xisphias/Lysimeter/logger/data/20170712/output/0711points1hr.png

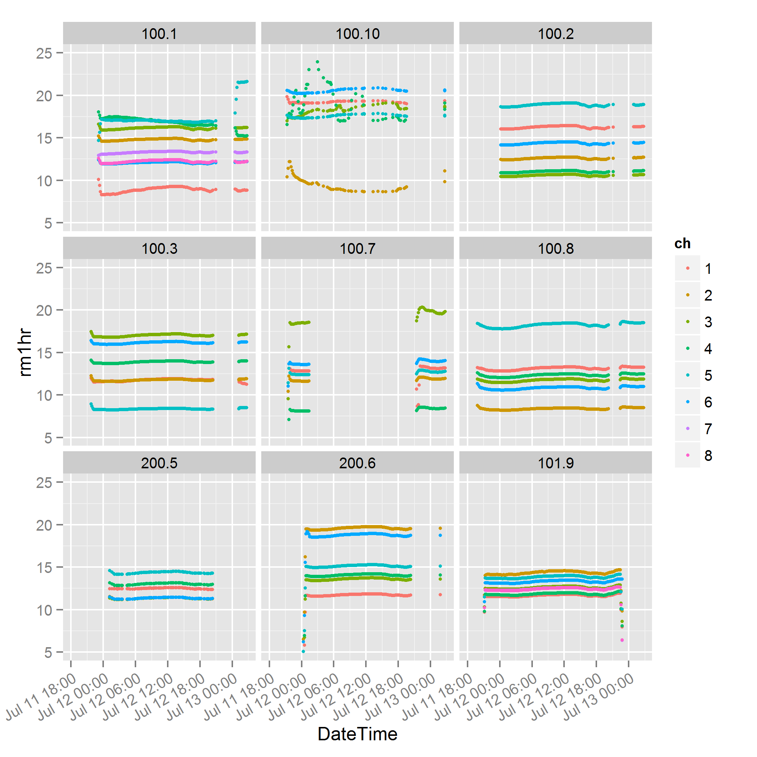
logger/data/20170712/output/0711points1hr.png
