xisphias/Lysimeter/logger/data/20170712/output/0712ETmm.png

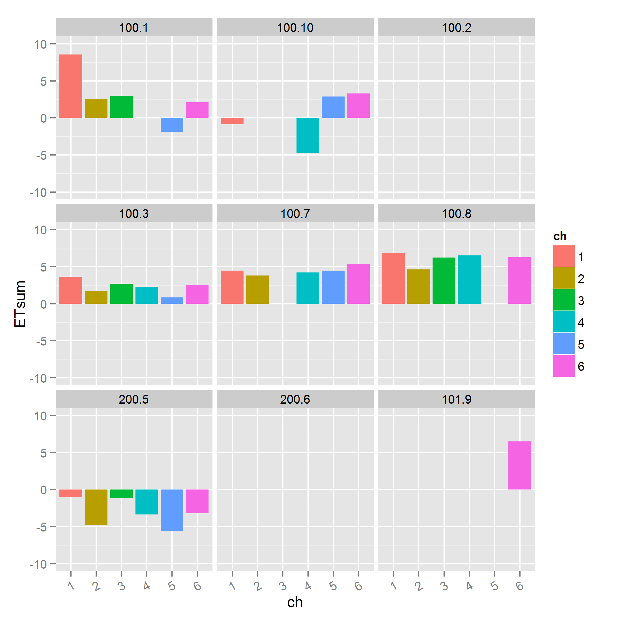
logger/data/20170712/output/0712ETmm.png
