xisphias/Lysimeter/logger/data/20170712/output/allpoints.png

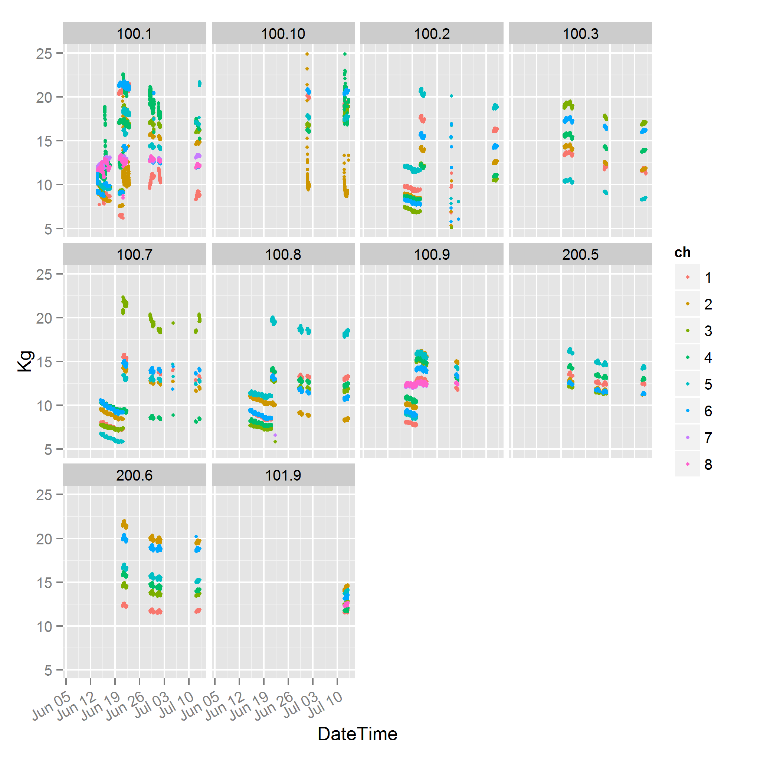
logger/data/20170712/output/allpoints.png
