xisphias/Lysimeter/node/pcb/brd_bottom.png

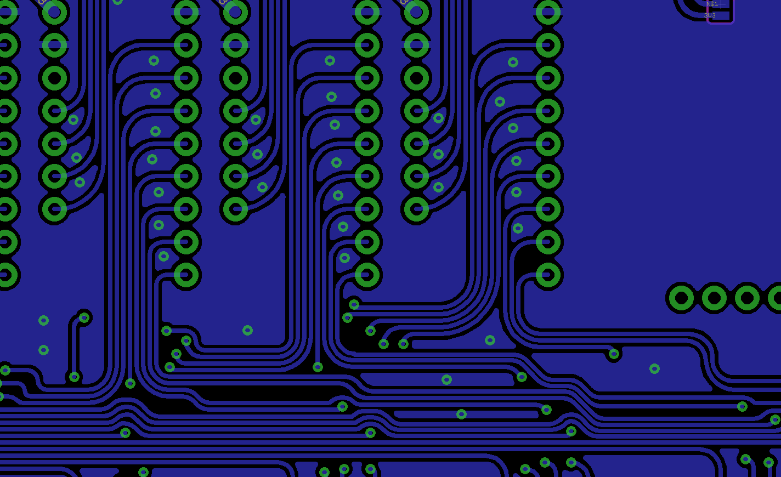
node/pcb/brd_bottom.png
