xisphias/Lysimeter/node/pcb/brd_silk.png

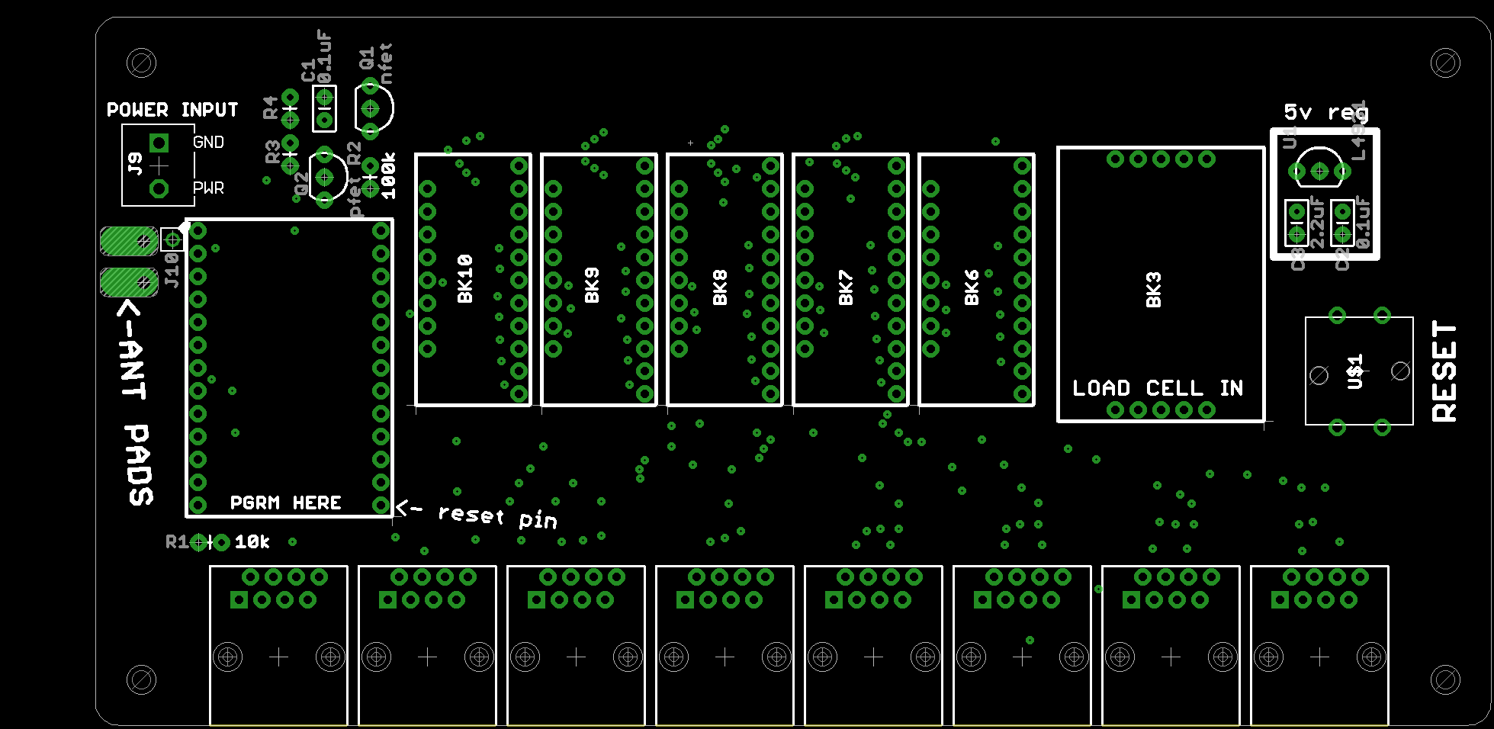
node/pcb/brd_silk.png
