xisphias/Lysimeter/node/pcb/brd_top.png

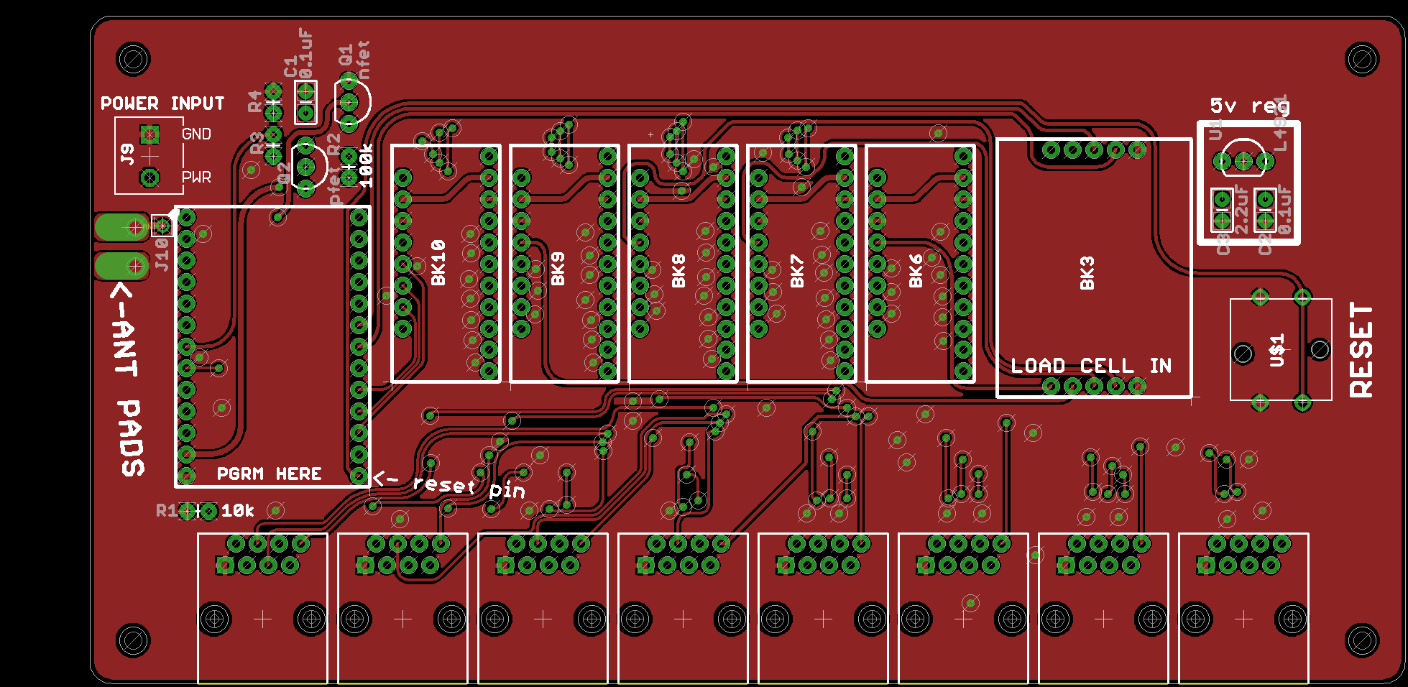
node/pcb/brd_top.png
