xisphias/Lysimeter/node/pcb/schematic.png

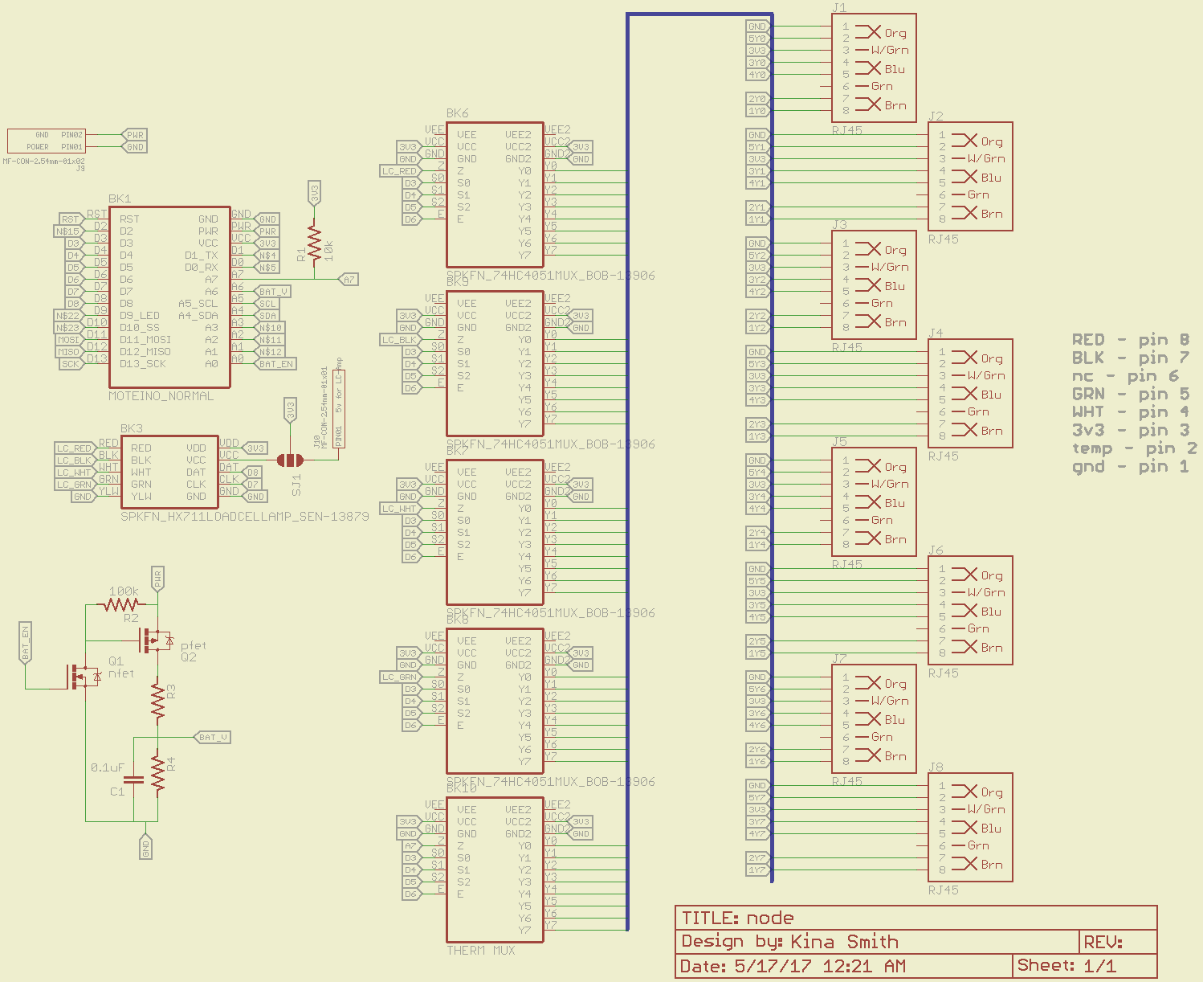
node/pcb/schematic.png
