xisphias/Lysimeter/node/pcb/schematicv2.png

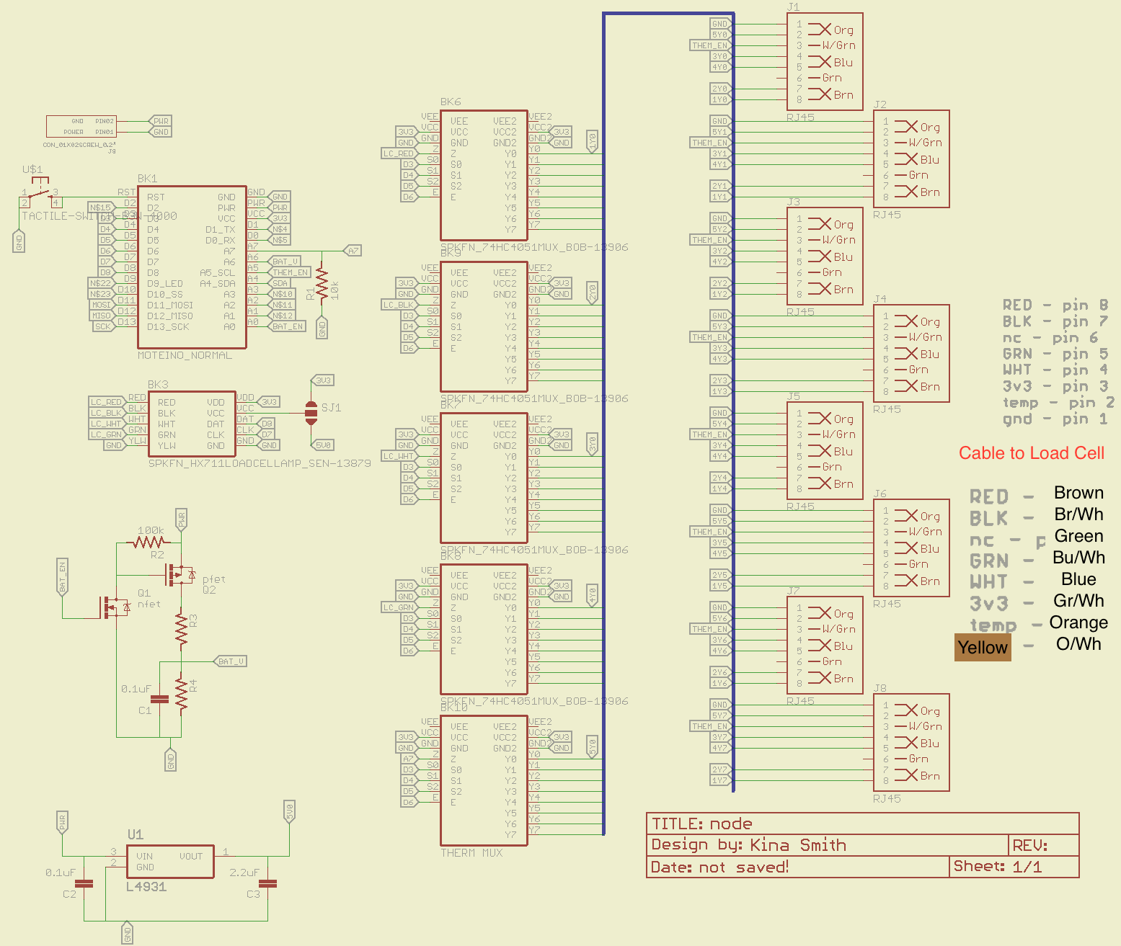
node/pcb/schematicv2.png
