xisphias/Lysimeter/logger/data/test_20170601_100_9.csv

batV | bTemp | nodeID | unixtime | ch1KG | ch1Temp | ch2KG | ch2Temp
0.01 | 21 | 100.9 | 1496267373 | 0.02 | 18.95 | 0.04 | 18.42
0.3 | 21 | 100.9 | 1496267392 | 0.02 | 19.04 | 0.04 | 18.51
0.04 | 22 | 100.9 | 1496267411 | 0.02 | 19.21 | 0.04 | 18.6
0.04 | 22 | 100.9 | 1496267469 | 0.02 | 19.21 | 0.04 | 18.6
0.04 | 22 | 100.9 | 1496267489 | 0.02 | 19.3 | 0.04 | 18.6
0.04 | 22 | 100.9 | 1496267508 | 0.02 | 19.3 | 0.04 | 18.6
0.06 | 22 | 100.9 | 1496267527 | 0.02 | 19.39 | 0.04 | 18.68
0.04 | 22 | 100.9 | 1496267546 | 0.02 | 19.39 | 0.04 | 18.68
0.04 | 22 | 100.9 | 1496267565 | 3.56 | 19.39 | 3.41 | 18.68
0.04 | 22 | 100.9 | 1496267584 | 3.56 | 19.39 | 3.41 | 18.68
0.04 | 22 | 100.9 | 1496267604 | 3.56 | 19.39 | 3.41 | 18.68
0.03 | 22 | 100.9 | 1496267642 | 3.56 | 19.48 | 3.41 | 18.68
0.04 | 22 | 100.9 | 1496267662 | 3.56 | 19.48 | 3.41 | 18.68
0.04 | 22 | 100.9 | 1496267681 | 3.56 | 19.48 | 3.41 | 18.68
0.04 | 22 | 100.9 | 1496267700 | 3.56 | 19.48 | 3.41 | 18.68
0.04 | 22 | 100.9 | 1496267719 | 3.56 | 19.48 | 3.41 | 18.77
0.03 | 23 | 100.9 | 1496267758 | 3.56 | 19.48 | 3.41 | 18.77
0.04 | 22 | 100.9 | 1496267777 | 3.56 | 19.56 | 3.41 | 18.77
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
