xisphias/Lysimeter/node/pcb/node.brd

## EAGLE design node/pcb/node.brd (2017-05-31, last stored version)

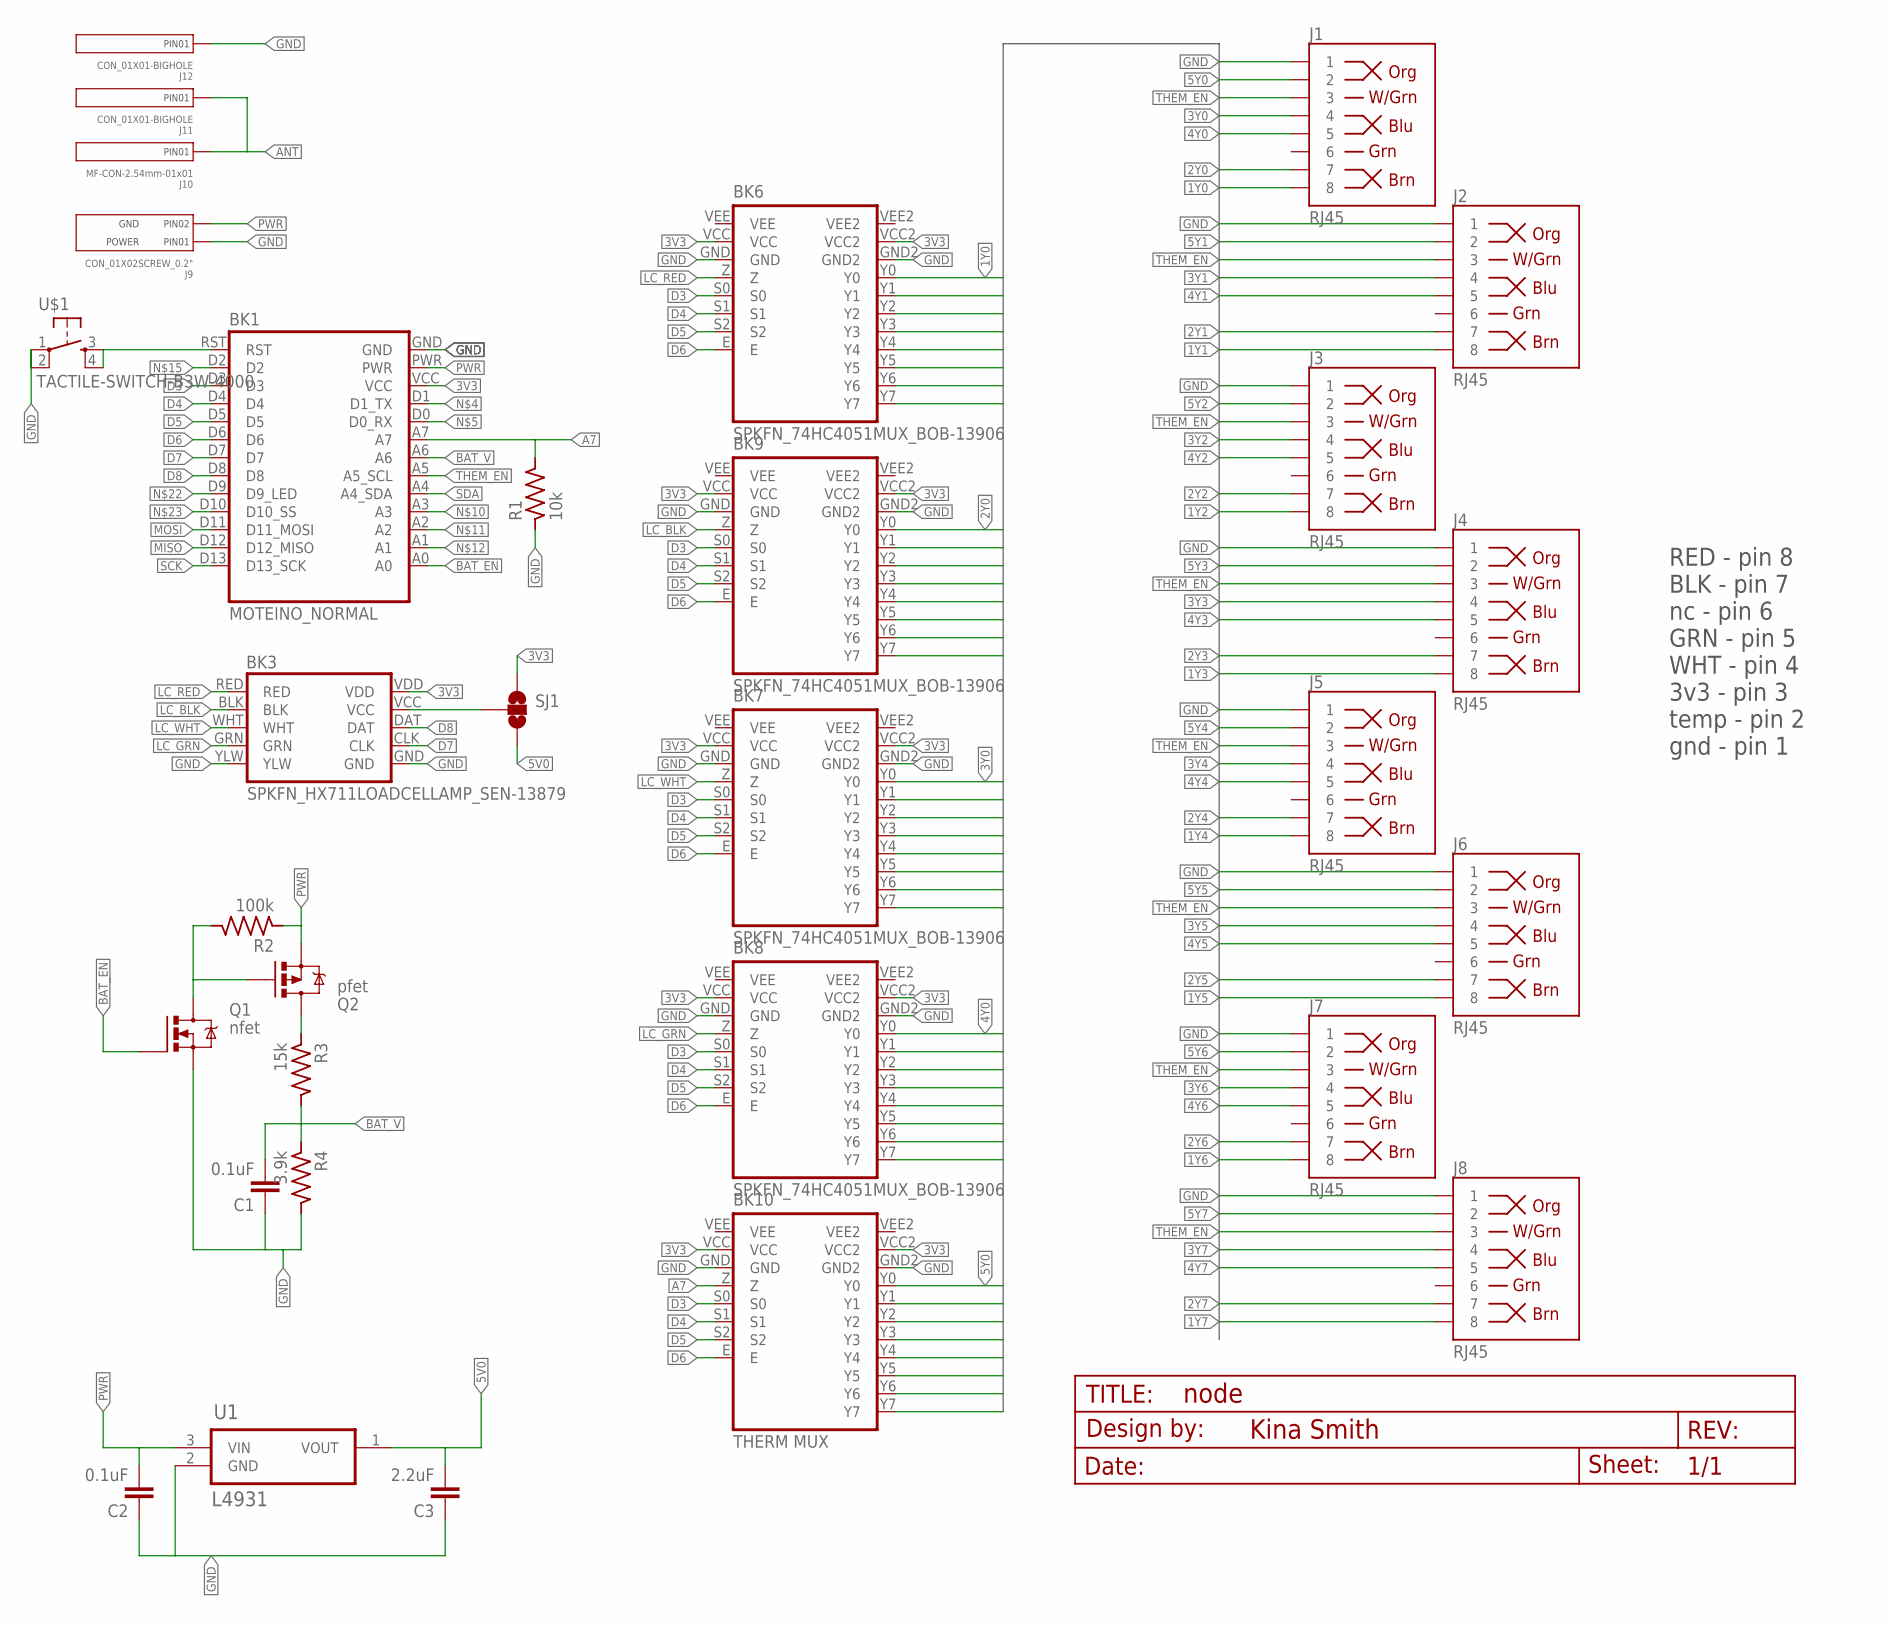
[picture p9: schematic node.sch]

Parts:
BK1: MOTEINO_NORMAL
BK3: SPKFN_HX711LOADCELLAMP_SEN-13879
BK6, BK7, BK8, BK9: SPKFN_74HC4051MUX_BOB-13906
BK10: THERM MUX; SPKFN_74HC4051MUX_BOB-13906
C1, C2: 0.1uF; CAP-PTH-SMALL2
C3: 2.2uF; CAP-PTH-SMALL2
FRAME1: FRAME-LETTERNO_PACKAGE; DUMMY
J1, J2, J3, J4, J5, J6, J7, J8: RJ45; RJ45-8
J9: CON_01X02SCREW_0.2"; SCREW_TERM_2POS
J10: MF-CON-2.54mm-01x01; PTH_2.54MM_01X01
J11, J12: CON_01X01-BIGHOLE; 1X01_BIGHOLE
Q1: nfet; TO-92-AMMO
Q2: pfet; TO-92-AMMO
R1: 10k; AXIAL-0.1
R2: 100k; AXIAL-0.1
R3: 15k; AXIAL-0.1
R4: 3.9k; AXIAL-0.1
SJ1: SOLDERJUMPER_2WAYS; SJ_3
U1: L4931; TO-92-AMMO
U$1: TACTILE-SWITCH-B3W-4000; B3W-4000

Connections:
1Y0: BK6.Y0, J1.8
1Y1: BK6.Y1, J2.8
1Y2: BK6.Y2, J3.8
1Y3: BK6.Y3, J4.8
1Y4: BK6.Y4, J5.8
1Y5: BK6.Y5, J6.8
1Y6: BK6.Y6, J7.8
1Y7: BK6.Y7, J8.8
2Y0: BK9.Y0, J1.7
2Y1: BK9.Y1, J2.7
2Y2: BK9.Y2, J3.7
2Y3: BK9.Y3, J4.7
2Y4: BK9.Y4, J5.7
2Y5: BK9.Y5, J6.7
2Y6: BK9.Y6, J7.7
2Y7: BK9.Y7, J8.7
3V3: BK1.VCC, BK3.VDD, BK6.VCC, BK6.VCC2, BK7.VCC, BK7.VCC2, BK8.VCC, BK8.VCC2, BK9.VCC, BK9.VCC2, BK10.VCC, BK10.VCC2, SJ1.1
3Y0: BK7.Y0, J1.4
3Y1: BK7.Y1, J2.4
3Y2: BK7.Y2, J3.4
3Y3: BK7.Y3, J4.4
3Y4: BK7.Y4, J5.4
3Y5: BK7.Y5, J6.4
3Y6: BK7.Y6, J7.4
3Y7: BK7.Y7, J8.4
4Y0: BK8.Y0, J1.5
4Y1: BK8.Y1, J2.5
4Y2: BK8.Y2, J3.5
4Y3: BK8.Y3, J4.5
4Y4: BK8.Y4, J5.5
4Y5: BK8.Y5, J6.5
4Y6: BK8.Y6, J7.5
4Y7: BK8.Y7, J8.5
5V0: C3.2, SJ1.3, U1.1 (VOUT)
5Y0: BK10.Y0, J1.2
5Y1: BK10.Y1, J2.2
5Y2: BK10.Y2, J3.2
5Y3: BK10.Y3, J4.2
5Y4: BK10.Y4, J5.2
5Y5: BK10.Y5, J6.2
5Y6: BK10.Y6, J7.2
5Y7: BK10.Y7, J8.2
A7: BK1.A7, BK10.Z, R1.P$2
ANT: J10.P$1, J11.P$1, J11.P$2
BAT_EN: BK1.A0, Q1.2 (G)
BAT_V: BK1.A6, C1.2, R3.P$2, R4.P$1
D3: BK1.D3, BK6.S0, BK7.S0, BK8.S0, BK9.S0, BK10.S0
D4: BK1.D4, BK6.S1, BK7.S1, BK8.S1, BK9.S1, BK10.S1
D5: BK1.D5, BK6.S2, BK7.S2, BK8.S2, BK9.S2, BK10.S2
D6: BK1.D6, BK6.E, BK7.E, BK8.E, BK9.E, BK10.E
D7: BK1.D7, BK3.CLK
D8: BK1.D8, BK3.DAT
GND: BK1.GND, BK3.GND, BK3.YLW, BK6.GND, BK6.GND2, BK7.GND, BK7.GND2, BK8.GND, BK8.GND2, BK9.GND, BK9.GND2, BK10.GND, BK10.GND2, C1.1, C2.1, C3.1, J1.1, J2.1, J3.1, J4.1, J5.1, J6.1, J7.1, J8.1, J9.GND (PIN1), J12.P$1, J12.P$2, Q1.1 (S), R1.P$1, R4.P$2, U1.2 (GND), U$1.1, U$1.2
LC_BLK: BK3.BLK, BK9.Z
LC_GRN: BK3.GRN, BK8.Z
LC_RED: BK3.RED, BK6.Z
LC_WHT: BK3.WHT, BK7.Z
MISO: BK1.D12 (D12_MISO)
MOSI: BK1.D11 (D11_MOSI)
unnamed: BK3.VCC, SJ1.2
unnamed: Q1.3 (D), Q2.2 (G), R2.P$2
unnamed: Q2.1 (D), R3.P$1
PWR: BK1.PWR, C2.2, J9.PWR (PIN2), Q2.3 (S), R2.P$1, U1.3 (VIN)
RST: BK1.RST, U$1.3, U$1.4
SCK: BK1.D13 (D13_SCK)
SDA: BK1.A4 (A4_SDA)
THEM_EN: BK1.A5 (A5_SCL), J1.3, J2.3, J3.3, J4.3, J5.3, J6.3, J7.3, J8.3

Notes on the sheet:
RED - pin 8 BLK - pin 7 nc - pin 6 GRN - pin 5 WHT - pin 4 3v3 - pin 3 temp - pin 2 gnd - pin 1

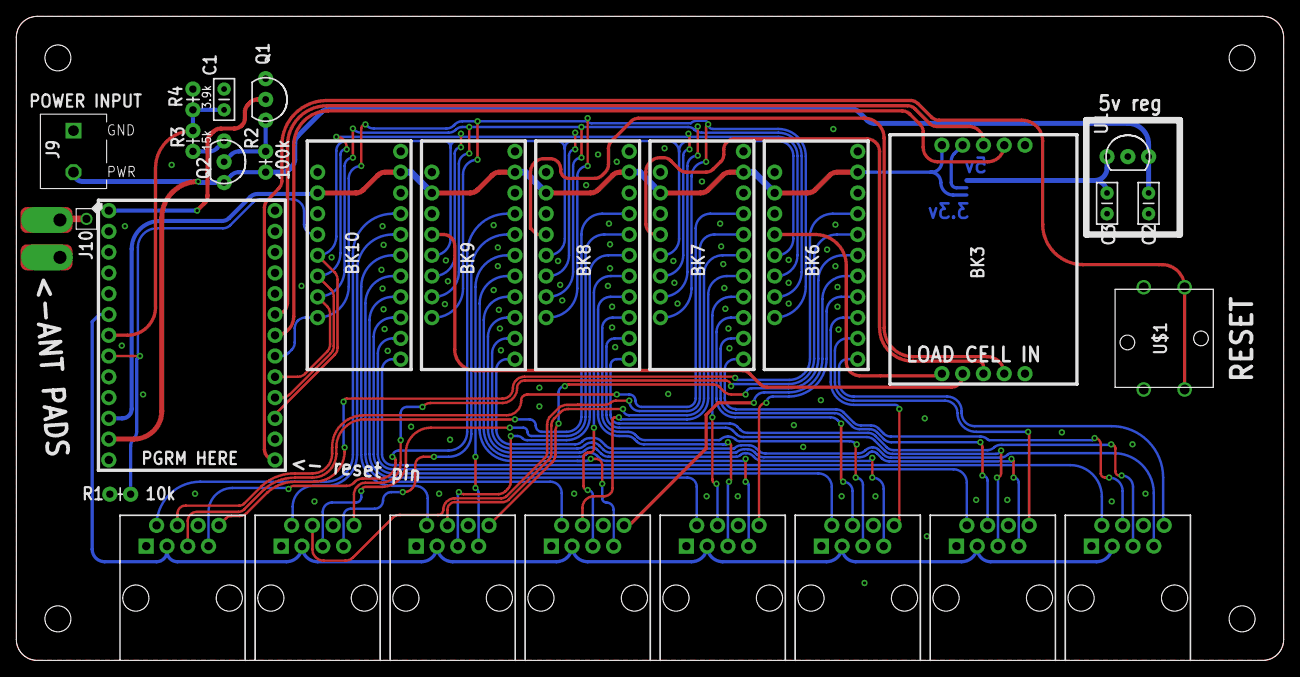
[picture p10: board node.brd from above]

Board: 2 copper layers, 154.9 x 78.7 mm, 32 parts (1 on the bottom side), 63 nets.
