xisphias/Lysimeter/logger/code/logger_v15_200/logger_v15_200.ino

/**
 * removed ping, timestamp, just listens for data
 * added rxrssi file
 * TODO:
 * Fix hang/fail
 *
 *
 *
 */
#include <Arduino.h> //built in
#include <SPI.h> //built in
#include <RFM69.h>
#include <RFM69_ATC.h>//https://www.github.com/lowpowerlab/rfm69
#include <SparkFunDS3234RTC.h> //https://github.com/kinasmith/SparkFun_DS3234_RTC_Arduino_Library
#include "SdFat.h" //https://github.com/greiman/SdFat

#define NETWORKID     200
#define NODEID 0 //Address on Network
#define FREQUENCY RF69_433MHZ //hardware frequency of Radio
#define IS_RFM69HW    //uncomment only for RFM69HW! 
//#define ATC_RSSI -70 //ideal signal strength
#define ACK_WAIT_TIME 30 // # of ms to wait for an ack
#define ACK_RETRIES 3 // # of attempts before giving up
#define SERIAL_BAUD 115200 //connection speed
#define RFM69_CS 10 //RFM69 CS pin
#define LED 9 //LED pin
#define SD_CS_PIN 7 //Chip Select pin for SD card
#define RTC_CS_PIN 8
#define CARD_DETECT 6 //Pin to detect presence of SD card
//#define INTERRUPT_PIN 2 // DeadOn RTC SQW/interrupt pin (optional)

//#define SERIAL_EN //Comment this out to remove Serial comms and save a few kb's of space
#ifdef SERIAL_EN
#define DEBUG(input)   {Serial.print(input); delay(1);}
#define DEBUGln(input) {Serial.println(input); delay(1);}
#define DEBUGFlush() { Serial.flush(); }
#else
#define DEBUG(input);
#define DEBUGln(input);
#define DEBUGFlush();
#endif

/*==============|| RFM69 ||==============*/
#ifdef ATC_RSSI
  RFM69_ATC radio;
#else
  RFM69 radio;
#endif//Declare Radio
byte lastRequesterNodeID = NODEID; //Last Sensor to communicate with this device

/*==============|| DS3231_RTC ||==============*/
uint32_t now; //Holder for Current Time

/*==============|| SD ||==============*/
SdFat SD; //Declare the sd Card
uint8_t CARD_PRESENT; //var for Card Detect sensor reading

/*==============|| Data ||==============*/
struct TimeStamp { //Place to Store the time
  uint32_t timestamp;
};
TimeStamp theTimeStamp;

//Holder for recieving data from sensors.
//NOTE: This must be THE SAME as the payload on the sensors.
struct Payload {
  uint16_t count = 0;
  int battery_voltage = 0;
  int board_temp = 0;
  long w[8] = {0,0,0,0,0,0,0,0};
  int t[8] = {0,0,0,0,0,0,0,0};
};
Payload thePayload;

void setup() {
//#ifdef SERIAL_EN
  Serial.begin(SERIAL_BAUD);
//#endif
  DEBUGln("+++++++++++++++++++++++++++++++++++++");
  Serial.println("-- Datalogger for Lysimeter System --");
  pinMode(LED, OUTPUT); //Set LED to output
  pinMode(CARD_DETECT, INPUT_PULLUP); //Init. 10k internal Pullup resistor
  initRTC();
  initSDCard();
  initRadio();
  DEBUGln("==========================");
}

void loop() {
  /*
  NOTE: There are a couple interesting things here.
  The radio listens for incoming packets on its network.
  If it recieves a packet, receiveDone() is called, triggering the code inside.
  The sensors will request information, or send information. The requests are logged
  inside of the receiveDone() function, but carried out when the function finishes.
  You can't do a bunch of slow stuff (like writing to an SD card) inside
  receiveDone() or it will break.
   */
  //initialize triggers as false
  bool writeData = false;
  bool reportTime = false;
  bool ping = false;
  
  if (radio.receiveDone()) { //if recieve packets from sensor...
//    DEBUG("rcv ");DEBUG(char(radio.DATA[0]));DEBUG(", ");DEBUG(radio.DATALEN); DEBUG(" byte/s from node "); DEBUG(radio.SENDERID); 
//    DEBUG(" [RX_RSSI:"); DEBUG(radio.RSSI); DEBUG("]");DEBUG(": ");
    lastRequesterNodeID = radio.SENDERID; //SENDERID is the Node ID of the device that sent the packet of data
//    rtc.update();  //this takes time...
//    now = rtc.unixtime(); //record time of this event
//    theTimeStamp.timestamp = now; //and save it to the global variable
	
	/*=== PING ==*/
    if(radio.DATALEN == 1 && radio.DATA[0] == 'p') {
//      DEBUG(radio.SENDERID); DEBUG(": ");
//      DEBUG("p ");
      ping = true;
    }
    /*=== TIME ==*/
    if(radio.DATALEN == 1 && radio.DATA[0] == 't') {
//      DEBUG("t ");
      reportTime = true;
    }
    /*=== PAYLOAD ==*/
    if (radio.DATALEN == sizeof(thePayload)) {
      thePayload = *(Payload*)radio.DATA; //assume radio.DATA actually contains our struct and not something else
      writeData = true;
      //NOTE: Be careful with too many prints and too much math in here. Do it in the writeData function down below
//      DEBUG("["); DEBUG(radio.SENDERID); DEBUGln("] ");
//      DEBUG("@: "); DEBUGln(thePayload.time);
    }
//    DEBUG("rcv ");DEBUG(char(radio.DATA[0]));DEBUG(", ");DEBUG(radio.DATALEN); DEBUG(" byte/s from node "); DEBUG(radio.SENDERID); 
//    DEBUG(" [RX:"); DEBUG(radio.RSSI); DEBUGln("]");
    if(radio.ACKRequested()){
		DEBUG(" .sending ack. ");
//      	Serial.println("ack");
      	radio.sendACK();
         delay(10);
    }
    Blink(LED,5);
  }
    DEBUG("rcv ");DEBUG(char(radio.DATA[0]));DEBUG(", ");DEBUG(radio.DATALEN); DEBUG(" byte/s from node "); DEBUG(radio.SENDERID); 
    DEBUG(" [RX:"); DEBUG(radio.RSSI); DEBUGln("]");

   
  /*=== DO THE RESPONSES TO THE MESSAGES ===*/
  //Sends the time to the sensor that requested it
  if (reportTime) {
    rtc.update();
    now = rtc.unixtime(); //record time of this event
    theTimeStamp.timestamp = now; //and save it to the global variable
    DEBUG("snd > "); DEBUG('['); DEBUG(lastRequesterNodeID); DEBUG("] ");
    if(radio.sendWithRetry(lastRequesterNodeID, (const void*)(&theTimeStamp), sizeof(theTimeStamp), ACK_RETRIES, ACK_WAIT_TIME)) {
      DEBUGln(theTimeStamp.timestamp);
    } else {
      DEBUGln("Failed . . . no ack");
    }
  }
  //sends a response back to confirm that the datalogger is alive
  if (ping) {
    Serial.println("ping");
//    DEBUG("snd > "); DEBUG('['); DEBUG(lastRequesterNodeID); DEBUG("] ");
//    if (radio.sendWithRetry(lastRequesterNodeID, (const void*)(1), sizeof(1), ACK_RETRIES, ACK_WAIT_TIME)) {
//      DEBUGln("1");
//    } else {
//      DEBUGln("Failed . . . no ack");
//    }
  }
  
  //write recieved data to the SD Card
  if (writeData) {
    Serial.print(lastRequesterNodeID); Serial.print(" ,c");
	Serial.print(thePayload.count); Serial.print(" , ");
    Serial.print(thePayload.battery_voltage); Serial.print("v, ");
	rtc.update();
    now = rtc.unixtime(); //record time of this event
    Serial.println(now);
	
    //Print out values that were recieved here, where there is time to kill
    DEBUGln("     : Y0\tY1\tY2\tY3\tY4\tY5\tY6\tY7");
    DEBUG("wts  : ");
    for (int i = 0; i < 8; i++) {
      DEBUG(thePayload.w[i]); //this is computationally expensive
      DEBUG(",\t");
    }
    DEBUGln(); DEBUG("temps: ");
    for (int i = 0; i < 8; i++) {
      DEBUG(thePayload.t[i]);
      DEBUG(",\t");
    }
    DEBUGln();
    DEBUG(" temp: "); DEBUGln(thePayload.board_temp);
    DEBUG(" battery voltage: "); DEBUGln(thePayload.battery_voltage);
    DEBUG(" cnt: "); DEBUG(thePayload.count);
    DEBUGln();

    File f; //declares a File
    String address = String(String(NETWORKID) + "_" + String(lastRequesterNodeID)); //creates a file name based off of Sender Address
    String fileName = String(address + ".csv"); //Save is a CSV file...because
    //convert String to Char Array
    char _fileName[fileName.length() +1];
    fileName.toCharArray(_fileName, sizeof(_fileName));
    //Open the File
    if (!f.open(_fileName, FILE_WRITE)) {
      DEBUG("sd - error opening ");
      DEBUG(_fileName);
      DEBUGln();
    }
    //And write data to that file
    Serial.print("sd - writing to "); Serial.print(_fileName); Serial.println();
    f.print(NETWORKID); f.print(".");
    f.print(radio.SENDERID); f.print(",");
    f.print(now); f.print(",");
    f.print(float(thePayload.battery_voltage)/100.0); f.print(",");
    f.print(thePayload.board_temp); f.print(",");
    for(int i = 0; i < 8; i++) {
      f.print(thePayload.w[i]); // these are *10000 need post processed to /10000
      f.print(",");
      f.print(float(thePayload.t[i])/100.0);
      f.print(",");
    }
    f.print(thePayload.count); f.println();
    f.close();
    //when done write, Close the File.
    //If file isn't closed, the data won't be saved
	
	  //Write rx rssi data
    File ff; //declares a File
    fileName = String("RxRssi.csv"); //Save is a CSV file...because
    //convert String to Char Array
    _fileName[fileName.length() +1];
    fileName.toCharArray(_fileName, sizeof(_fileName));
    //Open the File
    if (!ff.open(_fileName, FILE_WRITE)) {
      DEBUG("sd - error opening ");
      DEBUG(_fileName);
      DEBUGln();
    }
    //And write data to that file
    Serial.print("sd - writing to "); Serial.print(_fileName); Serial.println();
    ff.print(NETWORKID); ff.print(".");
    ff.print(radio.SENDERID); ff.print(",");
    ff.print(now); ff.print(",");
    ff.print(radio.RSSI); 
    ff.println();
    ff.close();
    //when done write, Close the File.
    //If file isn't closed, the data won't be saved
  }
  
  checkSdCard(); //Checks for card insertion
}

/**
 * Checks to make sure the SD Card is still present.
 */
void checkSdCard() {
  CARD_PRESENT = digitalRead(CARD_DETECT); //
  if (!CARD_PRESENT) {
    DEBUGln("sd - card Not Present");
    while (1) {
      Blink(LED, 100);
      Blink(LED, 200); //blink to show an error.
    }
  }
}
/**
 * Blinks an LED
 * @param PIN      Pin to Blink
 * @param DELAY_MS Time to Delay
 */
void Blink(byte PIN, int DELAY_MS) {
  digitalWrite(PIN,HIGH);
  delay(DELAY_MS);
  digitalWrite(PIN,LOW);
  delay(DELAY_MS);
}
/**
   [initRadio description]
*/
void initRadio()
{
  DEBUGln("-- Arduino RFM69HCW Transmitter");
  //Now initialise the radio
  delay(10);
  bool check = radio.initialize(FREQUENCY, NODEID, NETWORKID);
  if (check)
  {
    Serial.print("-- Network Address: "); Serial.print(NETWORKID); Serial.print("."); Serial.println(NODEID);
    #ifdef IS_RFM69HW 
      radio.setHighPower();
    #endif
    //radio.setPowerLevel(31); // power output ranges from 0 (5dBm) to 31 (20dBm)
    radio.encrypt("sampleEncryptKey");
    // radio.encrypt(ENCRYPTKEY);
    // radio.setFrequency(433000000);
#ifdef ATC_RSSI
    Serial.println("-- RFM69_ATC Enabled (Auto Transmission Control)");
    radio.enableAutoPower(ATC_RSSI);
#endif
    DEBUG("-- Transmitting at "); DEBUGln(radio.getFrequency());
  } else {
    Serial.println("-- Cannot initialize radio");
  }
}
void initRTC()
{
  // Call rtc.begin([cs]) to initialize the library
  // The chip-select pin should be sent as the only parameter
  rtc.begin(RTC_CS_PIN); //initialize RTC
  delay(10);
  //*****
  // rtc.autoTime();
  //*****
  // Update time/date values
  rtc.update();
  now = rtc.unixtime(); //get current time
  #ifdef INTERRUPT_PIN // If using the SQW pin as an interrupt
    pinMode(INTERRUPT_PIN, INPUT_PULLUP);
  #endif
  //printTime();
  digitalWrite(RTC_CS_PIN, HIGH);
}
void initSDCard()
{
  //Check if the SD Card initialized and able to write data
  //NOTE: This is SUPER important!!! If the SD Card fails to initialize
  //NOTE: no data will be saved. It is a MUST to test writing to a file, and having
  //NOTE: foolproof notifications if something goes wrong!!!
  bool sd_OK = false;
  digitalWrite(LED, HIGH); //turn LED on to signal start of test
  delay(10);
  CARD_PRESENT = digitalRead(CARD_DETECT); //read Card Detect pin
  if(CARD_PRESENT) { //If the Card is inserted correctly...
    Serial.print("-- SD Present, ");
    if (SD.begin(SD_CS_PIN)) { //Try initializing the Card...
      Serial.println("initialized, ");
      File f; //declare a File
//      SPI doesnt like using two spi devices concurrently
//      rtc update is now in the init rtc which happens just prior to this. 
//      rtc.update();
//      now = rtc.unixtime(); //get current time
      if(f.open("start.txt", FILE_WRITE)) { //Try opening that File
        Serial.println("file write, OK!");
        Serial.print("-- Time is "); Serial.println(now);
        //printTime();
        //Print to open File
        f.print("program started at: ");
        f.print(now);
        f.println();
        f.close(); //Close file
        sd_OK = true; //SD card is OK!
        digitalWrite(LED, LOW); //turn LED off
      }
    }
  }
  if(!sd_OK) { //If SD is not ok, blink forever.
    while(1) {
      Blink(LED, 100); //blink to show an error.
      Blink(LED, 200); //blink to show an error.
    }
  }

}
