xisphias/Lysimeter/(commit log)

2017-05-31 added pcb
    [node.brd, node.sch]
2017-05-31 fixed LED polarity
2017-06-01 added calibration array, added temperature
2017-06-01 more data typing
    couldn’t get 4 decimal places in sd with type casting and /10000 for
    weights. left that for post processing. converted all floats to ints or
    longs.
    [test_20170601_100_9.csv]
2017-06-02 modified button part
2017-06-03 moved Serial prints out of recieve loop
2017-06-03 messed up merge, v12 is current
2017-06-03 batV still not working
    reads 7.8 on 12v. ADC is 808.
    [batteryV.ino]
2017-06-03 fixed node 2 not working
    0 battery voltage was causing the send EEPROM to not sent and not erase, just keep thinking it had data to send....
    Fixed battery voltage to give a number (not the right one) and change the condition to count. Added counting.
2017-06-03 changed conversion math in batteryV. function
2017-06-03 fixed battery Volt math
2017-06-17 field deployment
    [100_1.csv, 100_5.csv, 100_7.csv, 100_8.csv]
2017-06-17 added cable wiring
2017-06-17 therm with calibration
2017-06-20 field deployment, fixed ping hang with timeout and retries
    [100_1.csv, 100_2.csv, 100_47.csv, 100_5.csv, 100_6.csv, 100_7.csv, 100_8.csv, 100_9.csv]
2017-06-22 field data
    [100_1.csv, 100_10.csv, 100_2.csv, 100_3.csv, 100_47.csv, 100_5.csv, 100_6.csv, 100_7.csv]
2017-06-29 data and testing node hang on 47
    [100_1.csv, 100_10.csv, 100_2.csv, 100_3.csv, 100_47.csv, 100_7.csv, 100_8.csv, 100_9.csv]
2017-07-01 field deploy
    [100_1.csv, 100_10.csv, 100_2.csv, 100_3.csv, 100_47.csv, 100_5.csv, 100_6.csv, 100_7.csv]
2017-08-02 chasing bugs
    [100_1.csv, 100_10.csv, 100_2.csv, 100_3.csv, 100_7.csv, 100_8.csv, 100_9.csv, 100_99.csv]
2017-09-01 final 2017 data
    [100_1.csv, 100_10.csv, 100_2.csv, 100_3.csv, 100_7.csv, 100_8.csv, 101_9.csv, 200_5.csv]
