xisphias/Lysimeter/(notices)

Notices in the files:
logger/code/Gateway_rtc_sd/Gateway_rtc_sd.ino:
Copyright Felix Rusu 2016, http://www.LowPowerLab.com/contact
Public License as published by the Free Software
parts and their libraries:
SparkFun-Capacitors: Licensing: Creative Commons ShareAlike 4.0 International - https://creativecommons.org/licenses/by-sa/4.0
My_Aesthetics: Released under the Creative Commons Attribution Share-Alike 4.0 License
My_Aesthetics: https://creativecommons.org/licenses/by-sa/4.0
